John-H-Elliott/ENCE461-PCB-Car-and-Controller/README.md

# ENCE461-PCB-Car-and-Controller

---

## **Overview**

This project was to design two PCBs, one for a remote-controlled car and the other for its controller. These can be found in the hardware section.

These boards were then programmed through a USB-Jtag programmer.

To learn more, refer to the guide used to structure this project in the documents section.

---
