John-H-Elliott/ENCE461-PCB-Car-and-Controller/Hardware/Hat/Final/Final PDFs/WR Hat Group 24.pdf

# USB Voltage Regulator

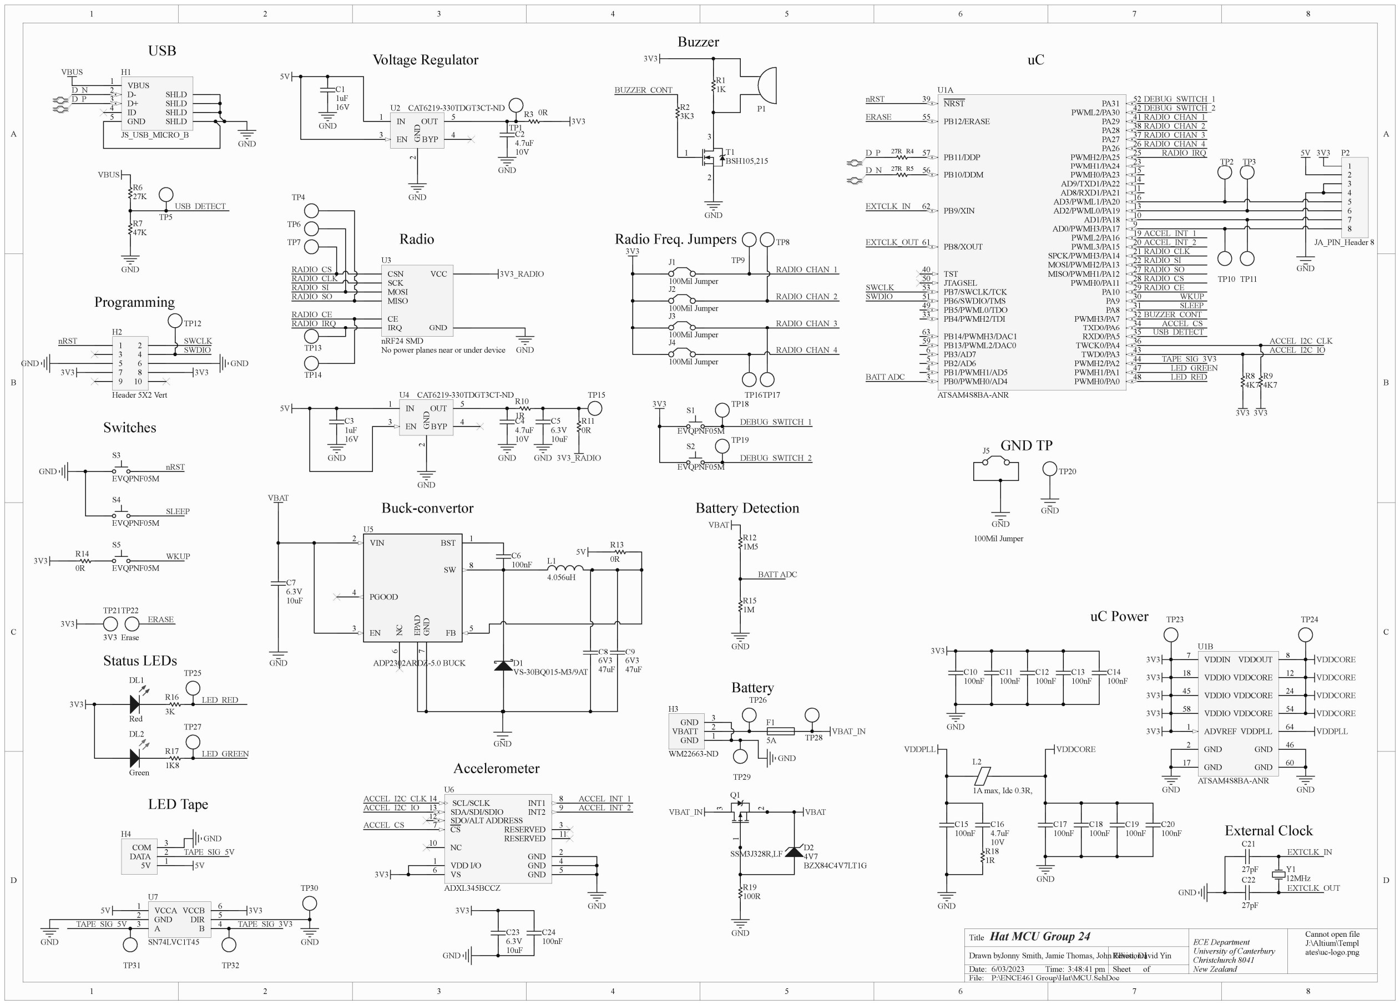
[picture p1: page 1]

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
ECE Department
University of Canterbury
Christchurch 8041
New Zealand

## Hat MCU Group 24

1
6/03/2023 | 3:48:41 pm
P:\ENCE461 Group\Hat\MCU.SchDoc

Title

Drawn by:
Date:
File:

Revision:
Time: | Sheet | of

Jonny Smith, Jamie Thomas, John Elliott, David Yin

Cannot open file
J:\Altium\Templ
ates\uc-logo.png
IN 1 | GND

2

EN 3 | BYP | 4
| OUT | 5

U2 CAT6219-330TDGT3CT-ND

JTAGSEL 50

NRST 39

PWMH0/PA0 | 48 PWMH1/PA1 | 47 PWMH2/PA2 | 44 TWD0/PA3 | 43 TWCK0/PA4 | 36 RXD0/PA5 | 35 TXD0/PA6 | 34 PWMH3/PA7 | 32 PA8 | 31 PA9 | 30 PA10 | 29 PWMH0/PA11 | 28 MISO/PWMH1/PA12 | 27 MOSI/PWMH2/PA13 | 22 SPCK/PWMH3/PA14 | 21 PWML3/PA15 | 20 PWML2/PA16 | 19 AD0/PWMH3/PA17 | 9
AD1/PA18 | 10 AD2/PWML0/PA19 | 13 AD3/PWML1/PA20 | 16 AD8/RXD1/PA21 | 11 AD9/TXD1/PA22 | 14 PWMH0/PA23 | 15 PWMH1/PA24 | 23 PWMH2/PA25 | 25 PA26 | 26 PA27 | 37 PA28 | 38 PA29 | 41 PWML2/PA30 | 42 PA31 | 52

PB0/PWMH0/AD4 3

PB1/PWMH1/AD5 4

PB2/AD6 5

PB3/AD7 6

PB4/PWMH2/TDI 33 | PB5/PWML0/TDO 49 | PB6/SWDIO/TMS 51 | PB7/SWCLK/TCK 53

PB8/XOUT 61

PB9/XIN 62

PB10/DDM 56

PB11/DDP 57

PB12/ERASE 55

PB13/PWML2/DAC0 59 PB14/PWMH3/DAC1 63

TST 40

U1A

ATSAM4S8BA-ANR

GND 2

GND 17

GND | 46
GND | 60
VDDCORE | 12
VDDCORE | 24
VDDCORE | 54

VDDIO 18

VDDIO 45

VDDIO 58

VDDPLL | 64 ADVREF 1
VDDOUT | 8 VDDIN 7

U1B

ATSAM4S8BA-ANR

S3

EVQPNF05M

S4

EVQPNF05M

Green

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
Header 5X2 Vert

# Programming

# Status LEDs

# Switches

# uC Power

uC

5V

1uF
16V

C1

GND

GND

4.7uF
10V

C2

3V3

GND

D_P

D_N

27R R4

VBUS

27K

R6

47K

R7

GND

USB_DETECT

USB_DETECT

GND | GND
3V3 | 3V3 SWCLK
| SWDIO

nRST

SWCLK
SWDIO

nRST

27R R5

12MHz

27pF Y1

C21

27pF

C22
GND

EXTCLK_IN

EXTCLK_OUT

EXTCLK_IN

EXTCLK_OUT

ERASE

ERASE

TP21

3V3

TP22

Erase

3V3

3V3

GND

100nF

C10
100nF

C11
100nF

C12
100nF

C13

3V3

3V3

3V3

3V3

100nF

C14

3V3

GND | GND

100nF

C15
4.7uF
10V

C16

GND

VDDPLL

1R

R18

VDDCORE

GND

100nF

C17
100nF

C18
100nF

C19
100nF

C20

VDDCORE

VDDCORE

VDDCORE

VDDCORE

1A max, Idc 0.3R,

L2

VDDPLL

3V3
3K

R16

1K8

R17

nRST

SLEEP

SLEEP

VCC

GND

CE

CSN
SCK
MOSI
MISO

IRQ

No power planes near or under device

U3

nRF24 SMD
GND

# Radio

IN 1 | GND

2

EN 3 | BYP | 4
| OUT | 5

U4 CAT6219-330TDGT3CT-ND
5V

1uF
16V

C3

GND

GND

4.7uF
10V

C4

GND | 3V3_RADIO

3V3_RADIO

6.3V
10uF

C5

GND

1R

R10

RADIO_CS
RADIO_CLK
RADIO_SI
RADIO_SO

RADIO_CE
RADIO_IRQ

RADIO_CS

RADIO_CLK
RADIO_SI
RADIO_SO

RADIO_CE

RADIO_IRQ

LED_GREEN

LED_RED

LED_RED

LED_GREEN

5V | 1
DATA | 2
COM | 3

H4

5V

GND

# LED Tape

VCCA 1
GND 2
A

### 3 B

4

DIR | 5
VCCB | 6

U7

GND | SN74LVC1T45
5V | 3V3

GND

TAPE_SIG_5V

TAPE_SIG_5V

TAPE_SIG_3V3

TAPE_SIG_3V3

VDD I/O 1

GND | 2
RESERVED | 3
GND | 4
GND | 5 VS 6

CS 7

| INT1 | 8
| INT2 | 9
NC 10 | RESERVED | 11
SDO/ALT ADDRESS 12 | SDA/SDI/SDIO 13 | SCL/SCLK 14

U6

ADXL345BCCZ

GND

3V3

3V3

GND

6.3V
10uF

C23
100nF

C24

ACCEL_I2C_CLK
ACCEL_I2C_IO

ACCEL_CS

ACCEL_CS

ACCEL_INT_1
ACCEL_INT_2

ACCEL_INT_1
ACCEL_INT_2

# Accelerometer

P1

3V3

1K

R1

BSH105,215

3
1

2

T1

3K3

R2

BUZZER_CONT

GND

BUZZER_CONT

# Buzzer

J1

100Mil Jumper
J2

100Mil Jumper
J3

100Mil Jumper
J4

100Mil Jumper

3V3

RADIO_CHAN_1

RADIO_CHAN_2

RADIO_CHAN_3

RADIO_CHAN_4

RADIO_CHAN_1
RADIO_CHAN_2
RADIO_CHAN_3
RADIO_CHAN_4

# Radio Freq. Jumpers

S1

EVQPNF05M
S2

EVQPNF05M

3V3

DEBUG_SWITCH_1

DEBUG_SWITCH_2

DEBUG_SWITCH_1
DEBUG_SWITCH_2

TP30

TP7

TP6

TP4

TP13

TP14

0R

R11

TP15

TP23 | TP24

TP25

TP27

TP5

R3 0R
TP1

VBUS 1
D- 2
D+ 3
ID 4
GND 5 | SHLD

SHLD

SHLD

SHLD

H1

JS_USB_MICRO_B

VBUS

D_N
D_P

GND

TP19

TP18

GND

TP31 | TP32

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
JA_PIN_Header 8

GND
TP10 TP11

TP2 TP3

5V 3V3

TP16TP17

TP9

TP8

FB | 5
VIN 2 | BST | 1 NC | EPAD

6

PGOOD 4

EN 3

SW 8 GND

7

U5

ADP2302ARDZ-5.0 BUCK

VBAT

5V

6.3V
10uF

C7

GND

100nF

C6

6V3
47uF

C8
6V3
47uF

C9

GND

D1
VS-30BQ015-M3/9AT

4.056uH

L1

# Buck-convertor

J5

100Mil Jumper

GND

GND

TP20

# GND TP

# External Clock

TP12

1M5

R12

1M

R15

GND

VBAT

BATT ADC

BATT ADC

# Battery Detection

GND | 1
VBATT | 2
GND | 3

WM22663-ND

H3

VBAT_IN

GND

# Battery

5A

F1
TP28

TP29

TP26

SSM3J328R,LF ³

1

2

Q1

VBAT_IN

GND

BZX84C4V7LT1G

D2
4V7

100R

R19

VBAT

0R

R13

3V3

WKUP

S5

EVQPNF05M

WKUP

3V3
0R

R14

4K7

R9

3V3

ACCEL_I2C_CLK
ACCEL_I2C_IO

4K7

R8
