John-H-Elliott/ENCE461-PCB-Car-and-Controller/Documents/guide/figs/chassis.jpg

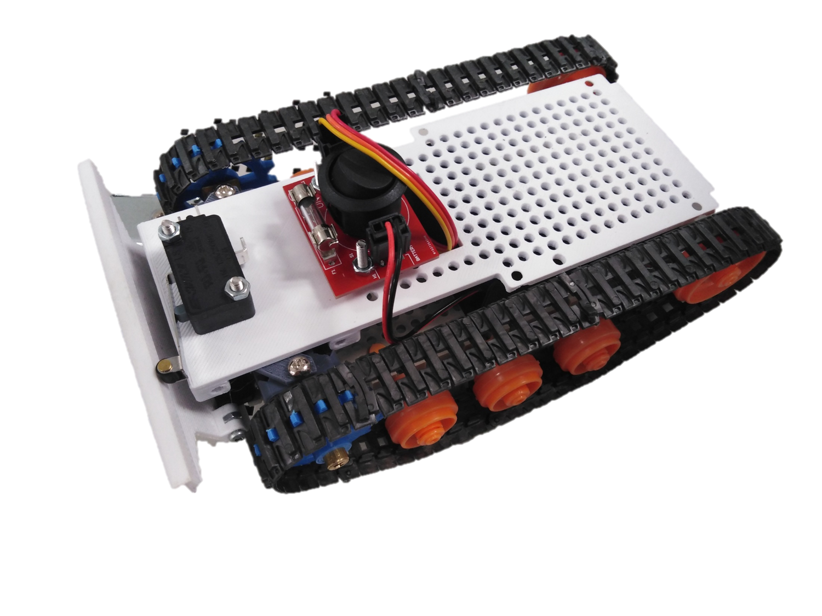
Documents/guide/figs/chassis.jpg
