John-H-Elliott/ENCE461-PCB-Car-and-Controller/Documents/guide/figs/ClockSignal.png

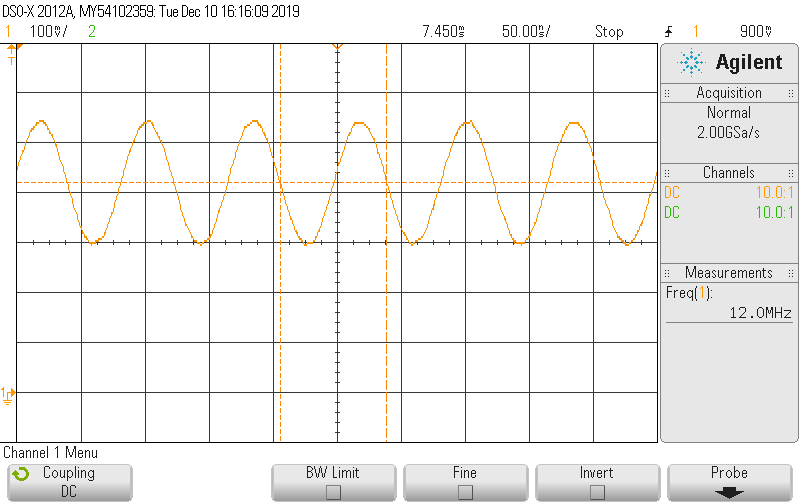
Documents/guide/figs/ClockSignal.png
