John-H-Elliott/ENCE461-PCB-Car-and-Controller/Documents/guide/figs/i2c-ack.png

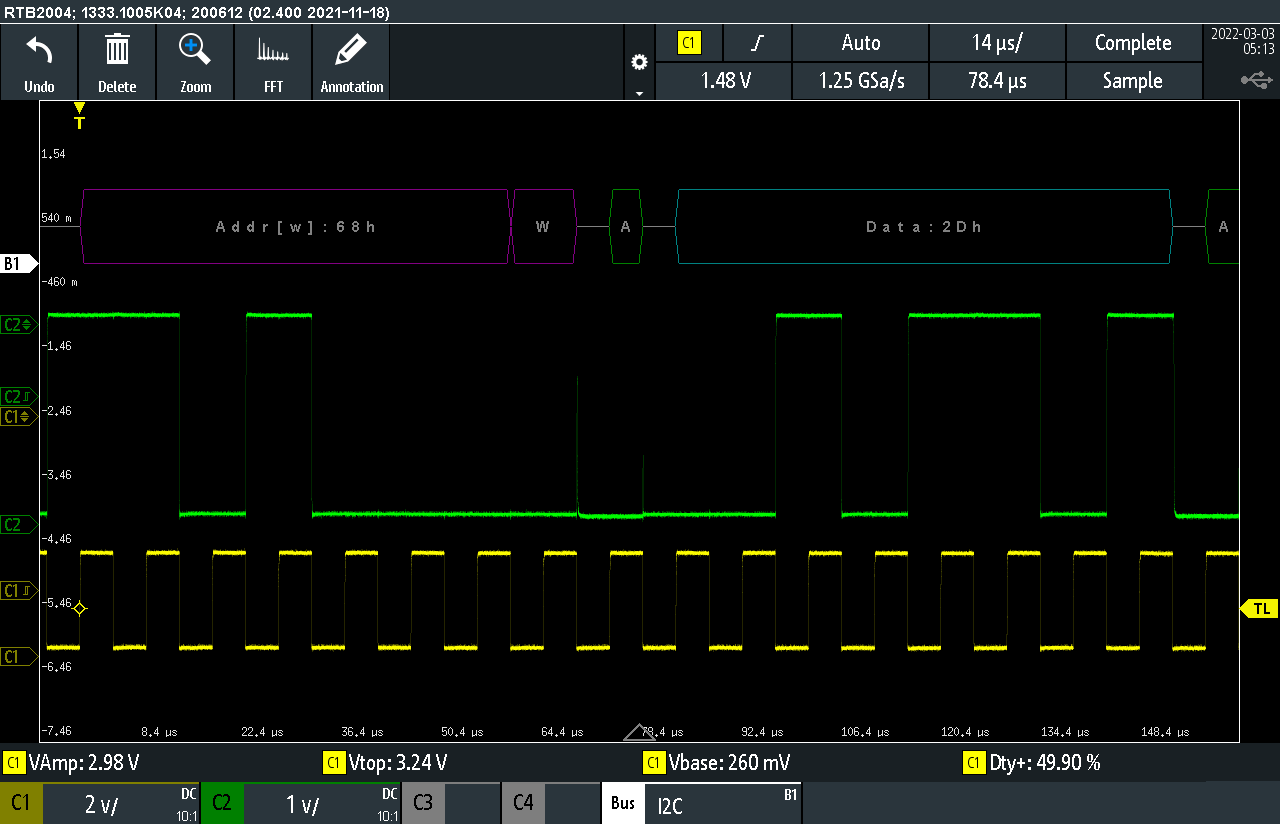
Documents/guide/figs/i2c-ack.png
