John-H-Elliott/ENCE461-PCB-Car-and-Controller/Documents/guide/figs/jumpers4.jpg

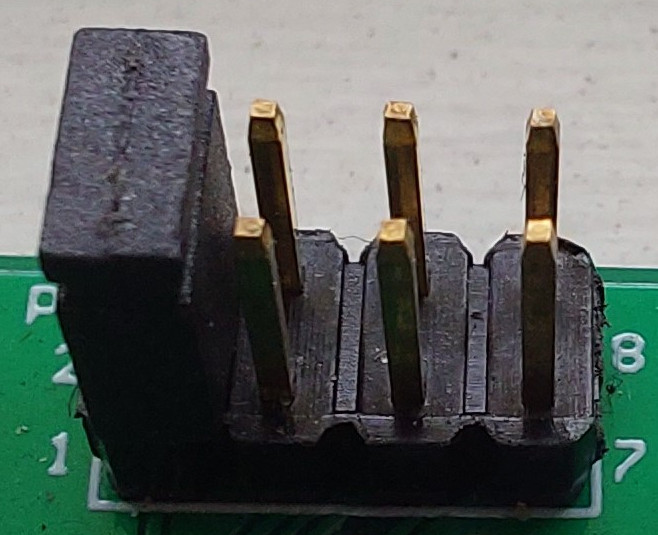
Documents/guide/figs/jumpers4.jpg
