John-H-Elliott/ENCE461-PCB-Car-and-Controller/Documents/guide/figs/jumpers.jpg

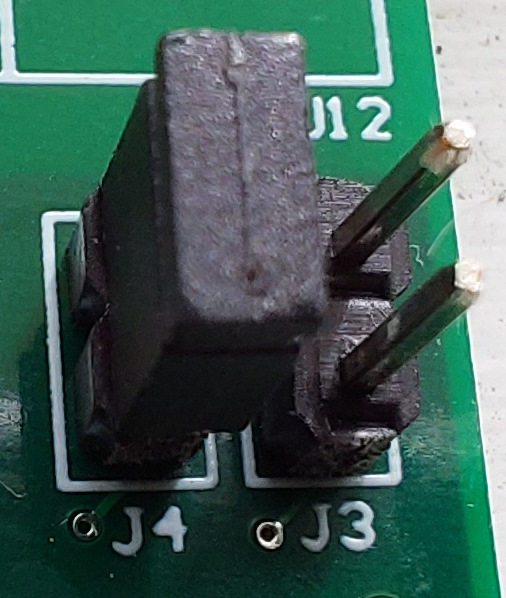
Documents/guide/figs/jumpers.jpg
