John-H-Elliott/ENCE461-PCB-Car-and-Controller/Documents/guide/figs/led_tape.jpg

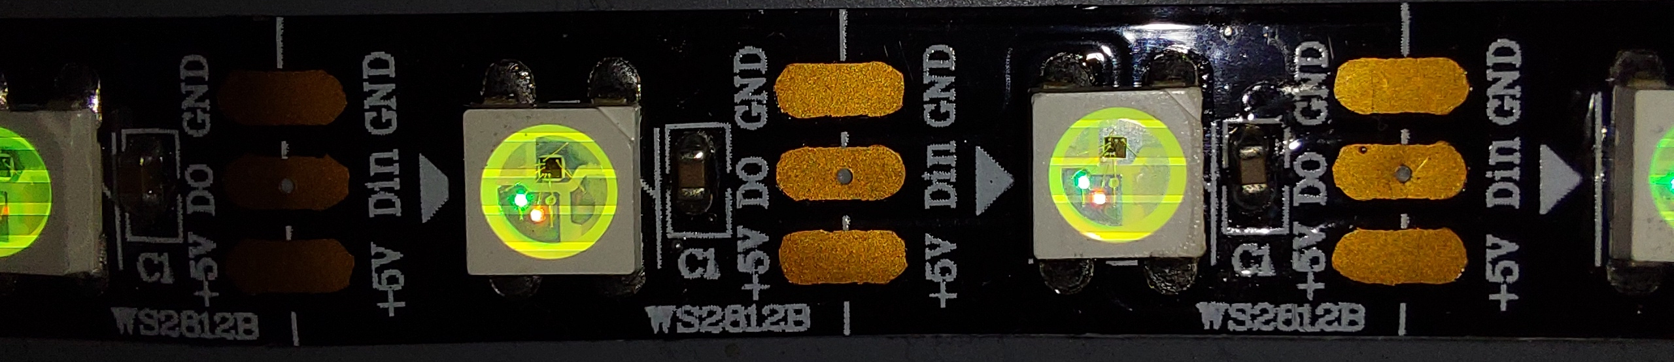
Documents/guide/figs/led_tape.jpg
