John-H-Elliott/ENCE461-PCB-Car-and-Controller/Documents/guide/figs/nrf24.jpg

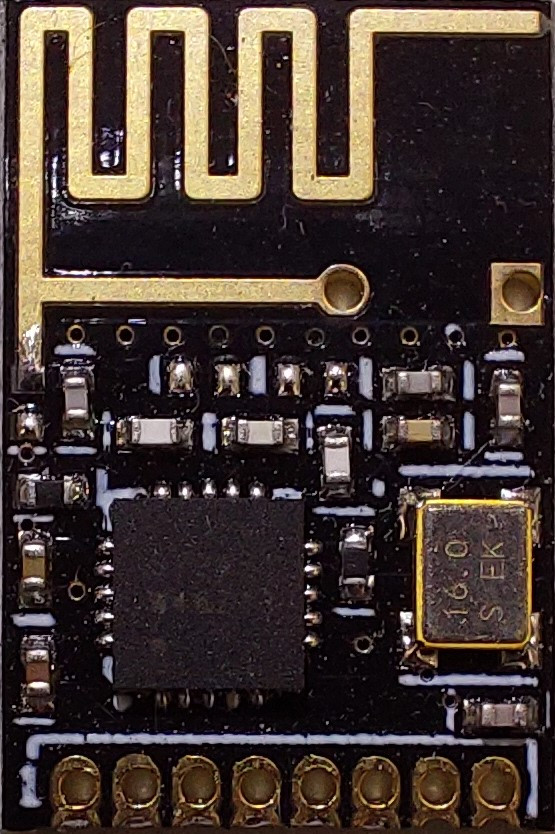
Documents/guide/figs/nrf24.jpg
