John-H-Elliott/ENCE461-PCB-Car-and-Controller/Documents/guide/figs/OpenOCDPollingGood.png

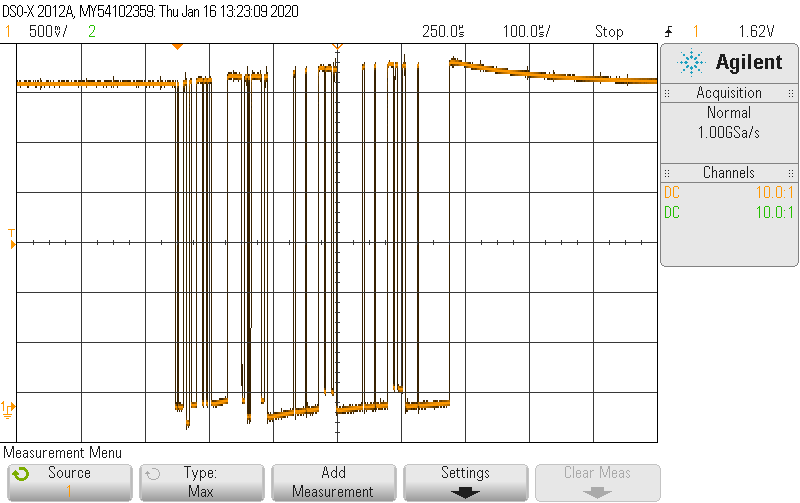
Documents/guide/figs/OpenOCDPollingGood.png
