John-H-Elliott/ENCE461-PCB-Car-and-Controller/Documents/guide/figs/OpenOCDTimingGood.png

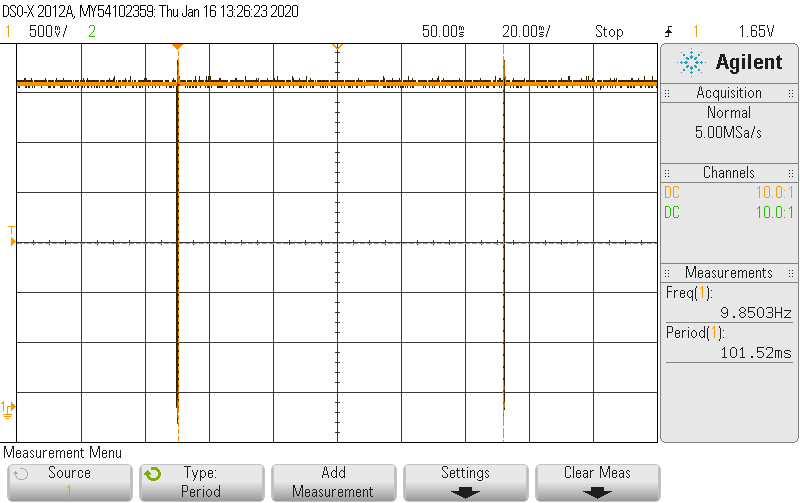
Documents/guide/figs/OpenOCDTimingGood.png
