John-H-Elliott/ENCE461-PCB-Car-and-Controller/Documents/guide/figs/probe-compensated.jpg

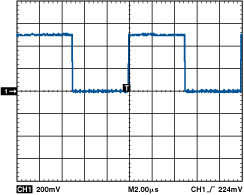
Documents/guide/figs/probe-compensated.jpg
