John-H-Elliott/ENCE461-PCB-Car-and-Controller/Documents/guide/figs/probe-overcompensated.jpg

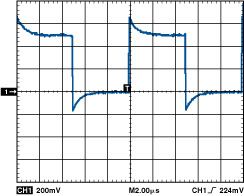
Documents/guide/figs/probe-overcompensated.jpg
