John-H-Elliott/ENCE461-PCB-Car-and-Controller/Documents/guide/figs/PWM_2.png

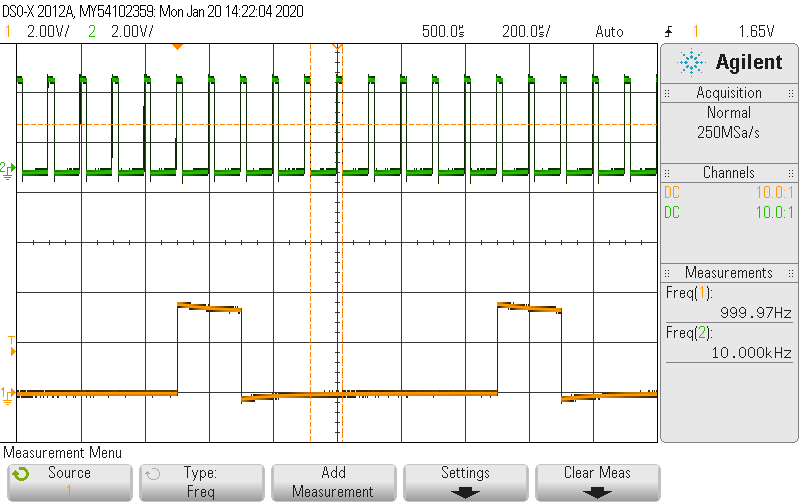
Documents/guide/figs/PWM_2.png
