John-H-Elliott/ENCE461-PCB-Car-and-Controller/Documents/guide/figs/solder_bridge.jpg

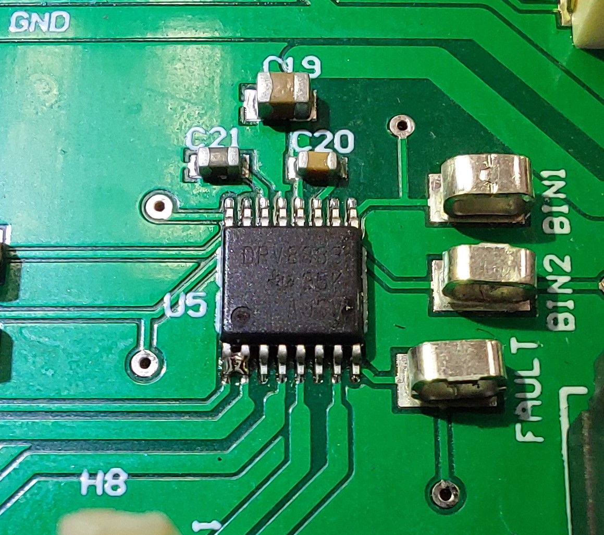
Documents/guide/figs/solder_bridge.jpg
