John-H-Elliott/ENCE461-PCB-Car-and-Controller/Documents/guide/figs/wacky_mural.jpg

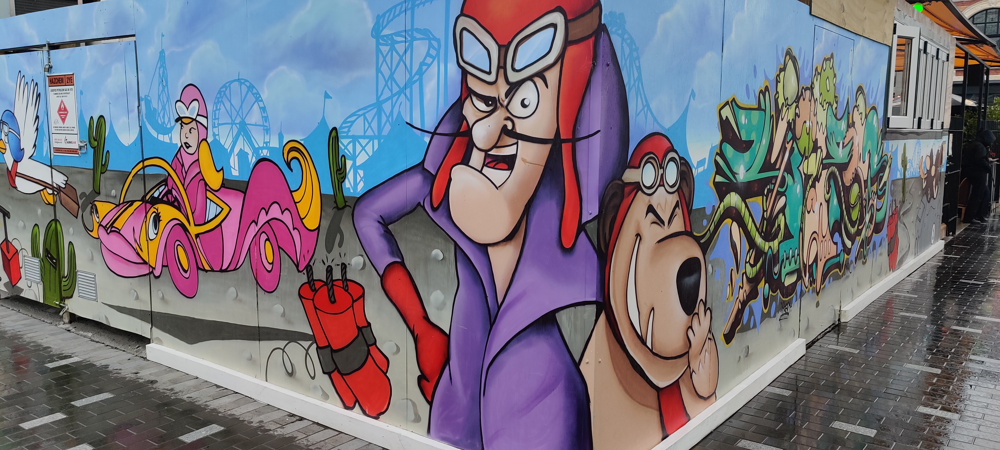
Documents/guide/figs/wacky_mural.jpg
