John-H-Elliott/ENCE461-PCB-Car-and-Controller/Hardware/Car/Final/Final PDFs/Wacky_Racers_extras.pdf

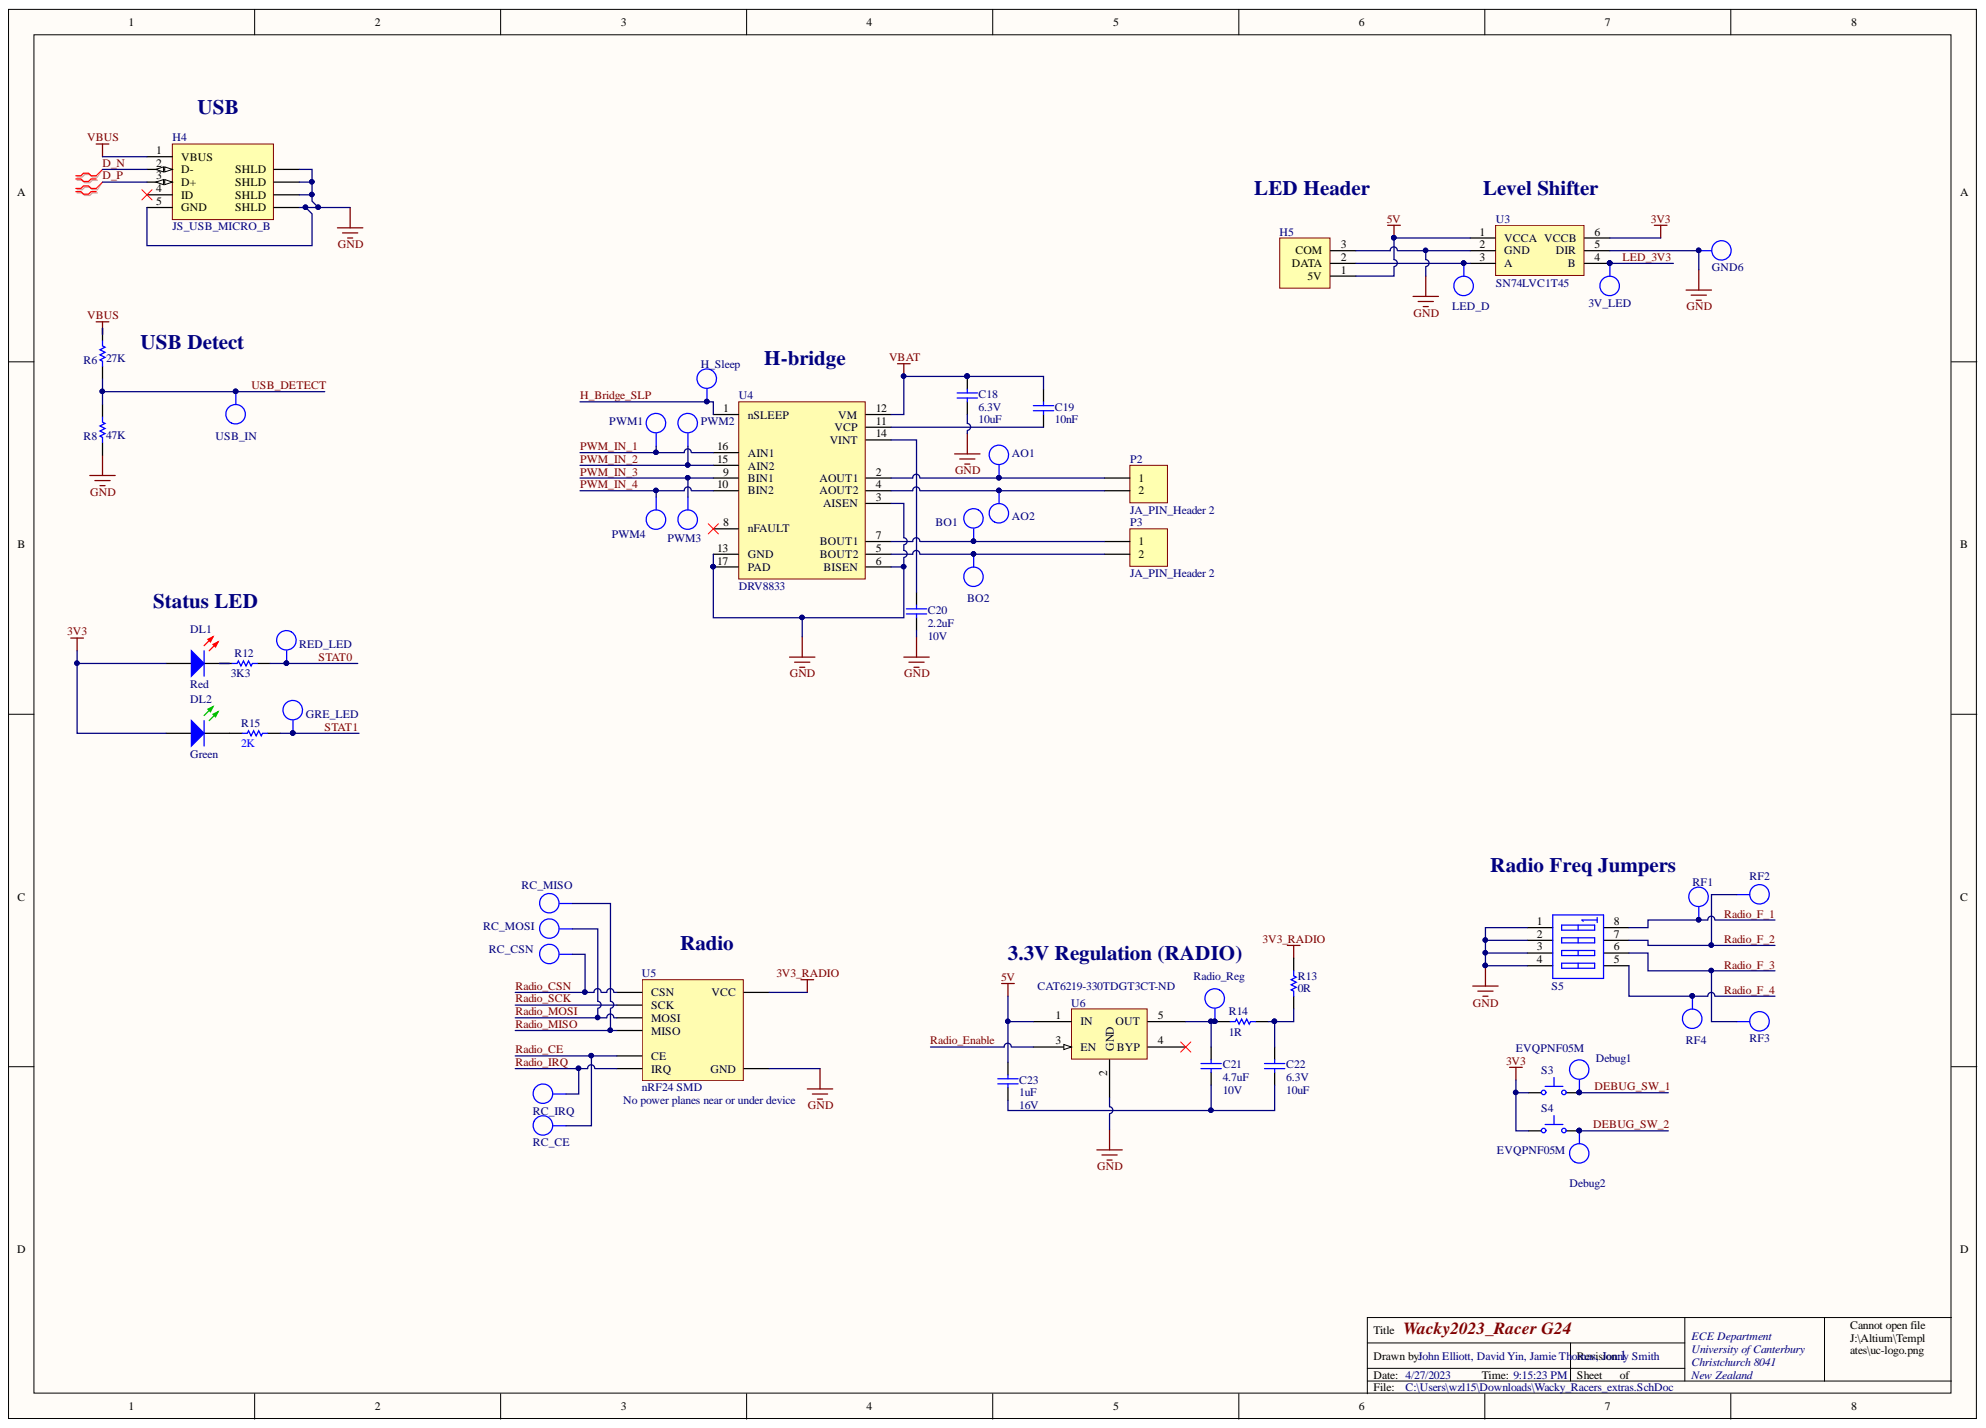
[picture p25: page 1]

IRQ
nRF24 SMD
No power planes near or under device

Wacky2023_Racer G24 Title | ECE Department University of Canterbury Christchurch 8041 New Zealand | Cannot open file J:\Altium\Templ ates\uc-logo.png

Drawn by: John Elliott, David Yin, Jamie Thomas, Jonny Smith | Revision: 1

Date: 4/27/2023 Time: 9:15:23 PM | Sheet of

# Board Stack Report
