John-H-Elliott/ENCE461-PCB-Car-and-Controller/Hardware/Hat/Final/Final PDFs/Wacky_Racers_Group24_Hat.pdf

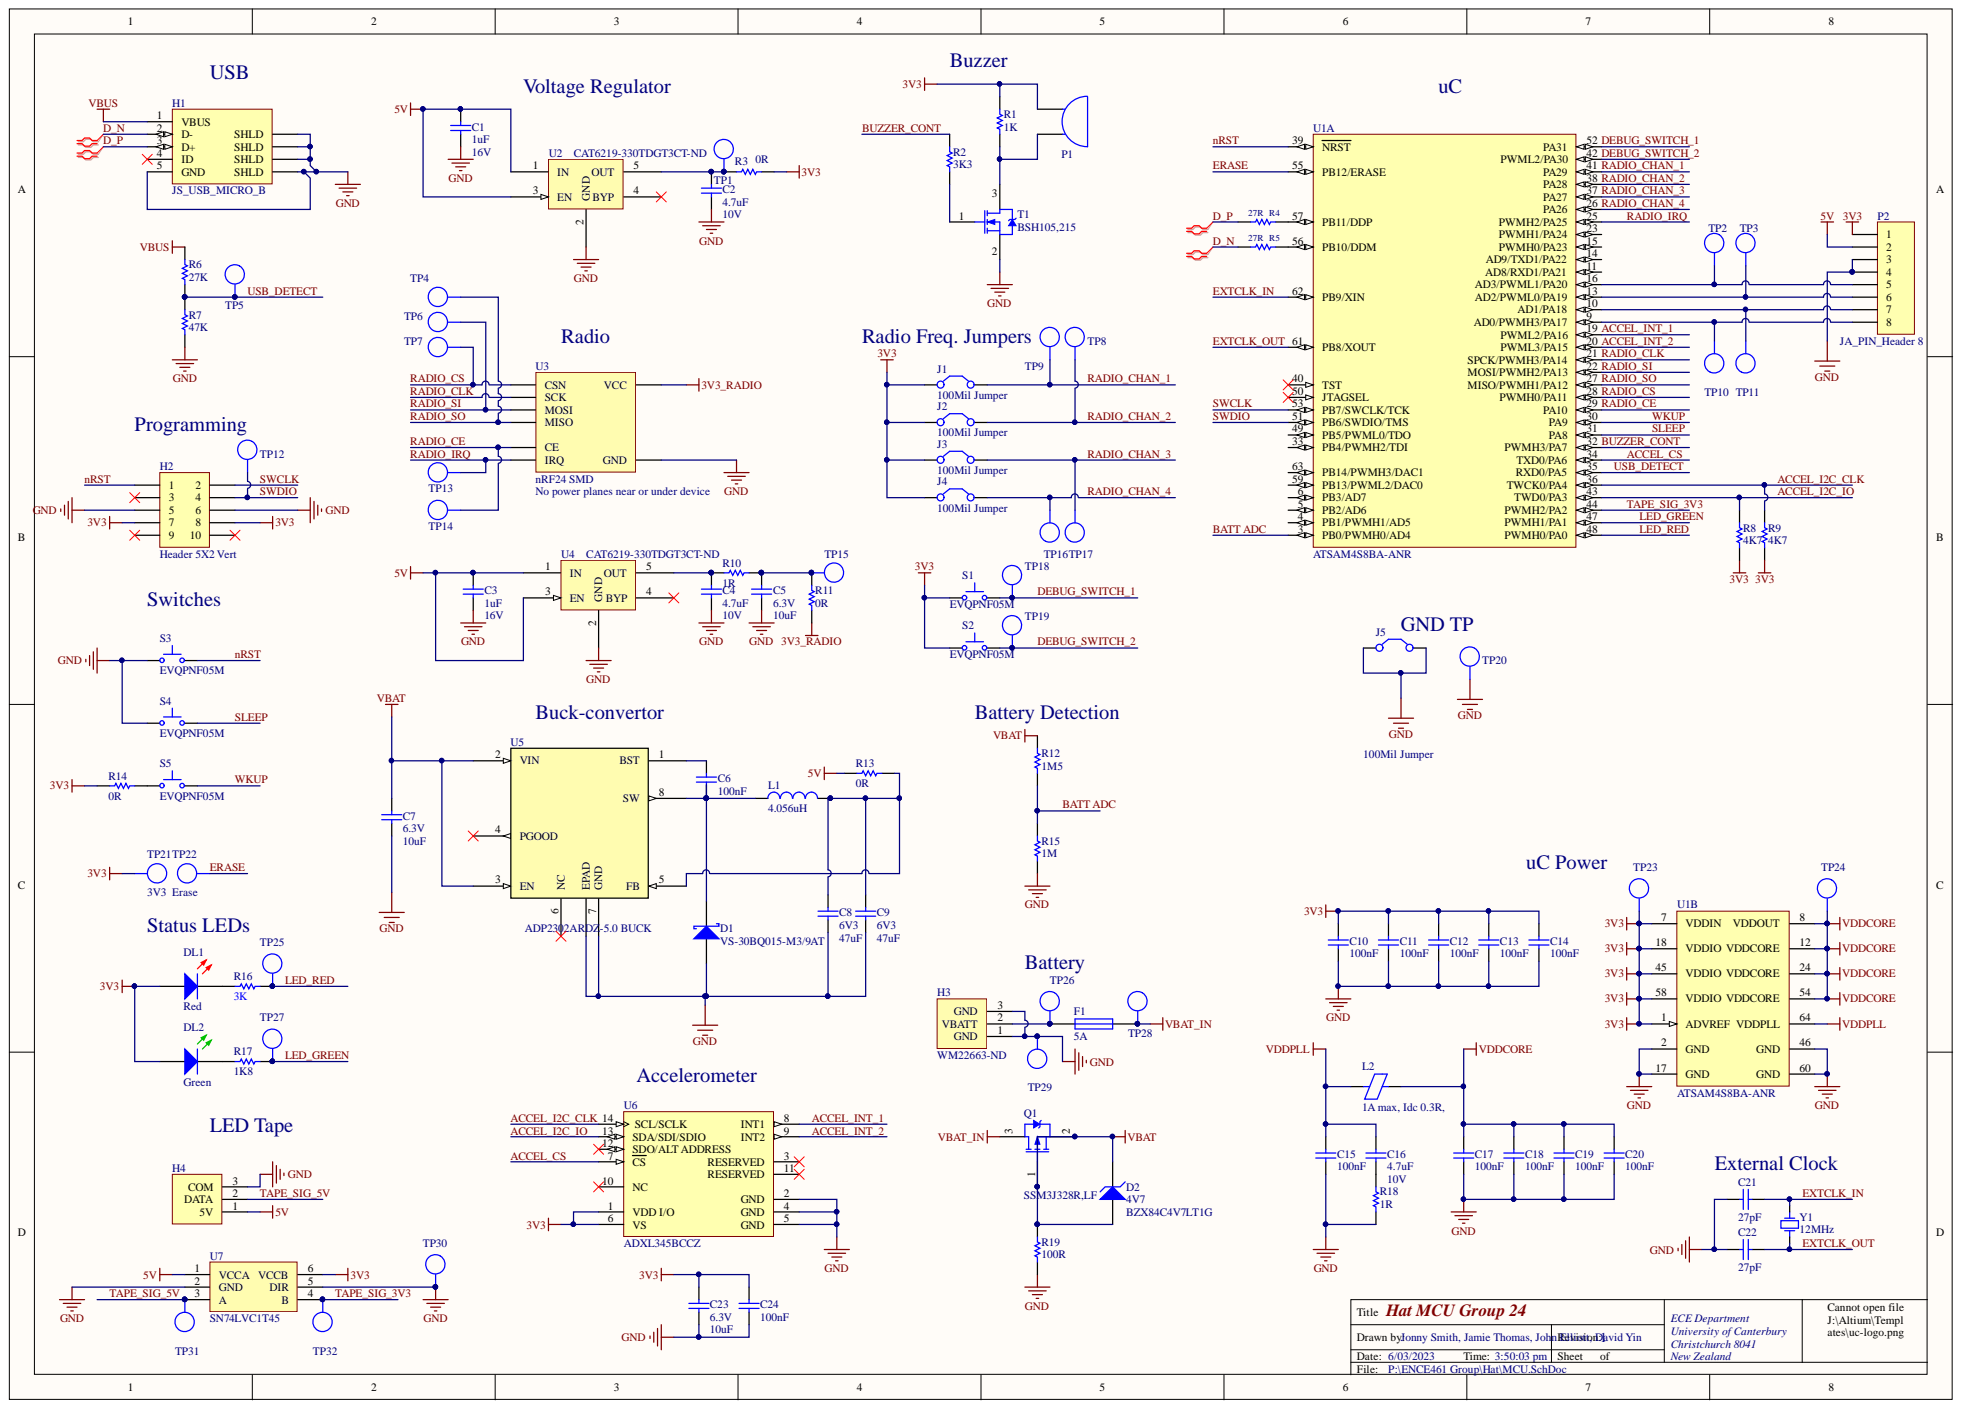
[picture p26: page 1]

IRQ
nRF24 SMD
No power planes near or under device

VDDIO 58

GND 2

Cannot open file
J:\Altium\Templ
ates\uc-logo.png

Drawn by:
P:\ENCE461 Group\Hat\MCU.SchDoc

Jonny Smith, Jamie Thomas, John Elliott, David Yin
