John-H-Elliott/ENCE461-PCB-Car-and-Controller/Hardware/Hat/Final/Final PDFs/Wacky_Racers_Group24_Hat_V2.pdf

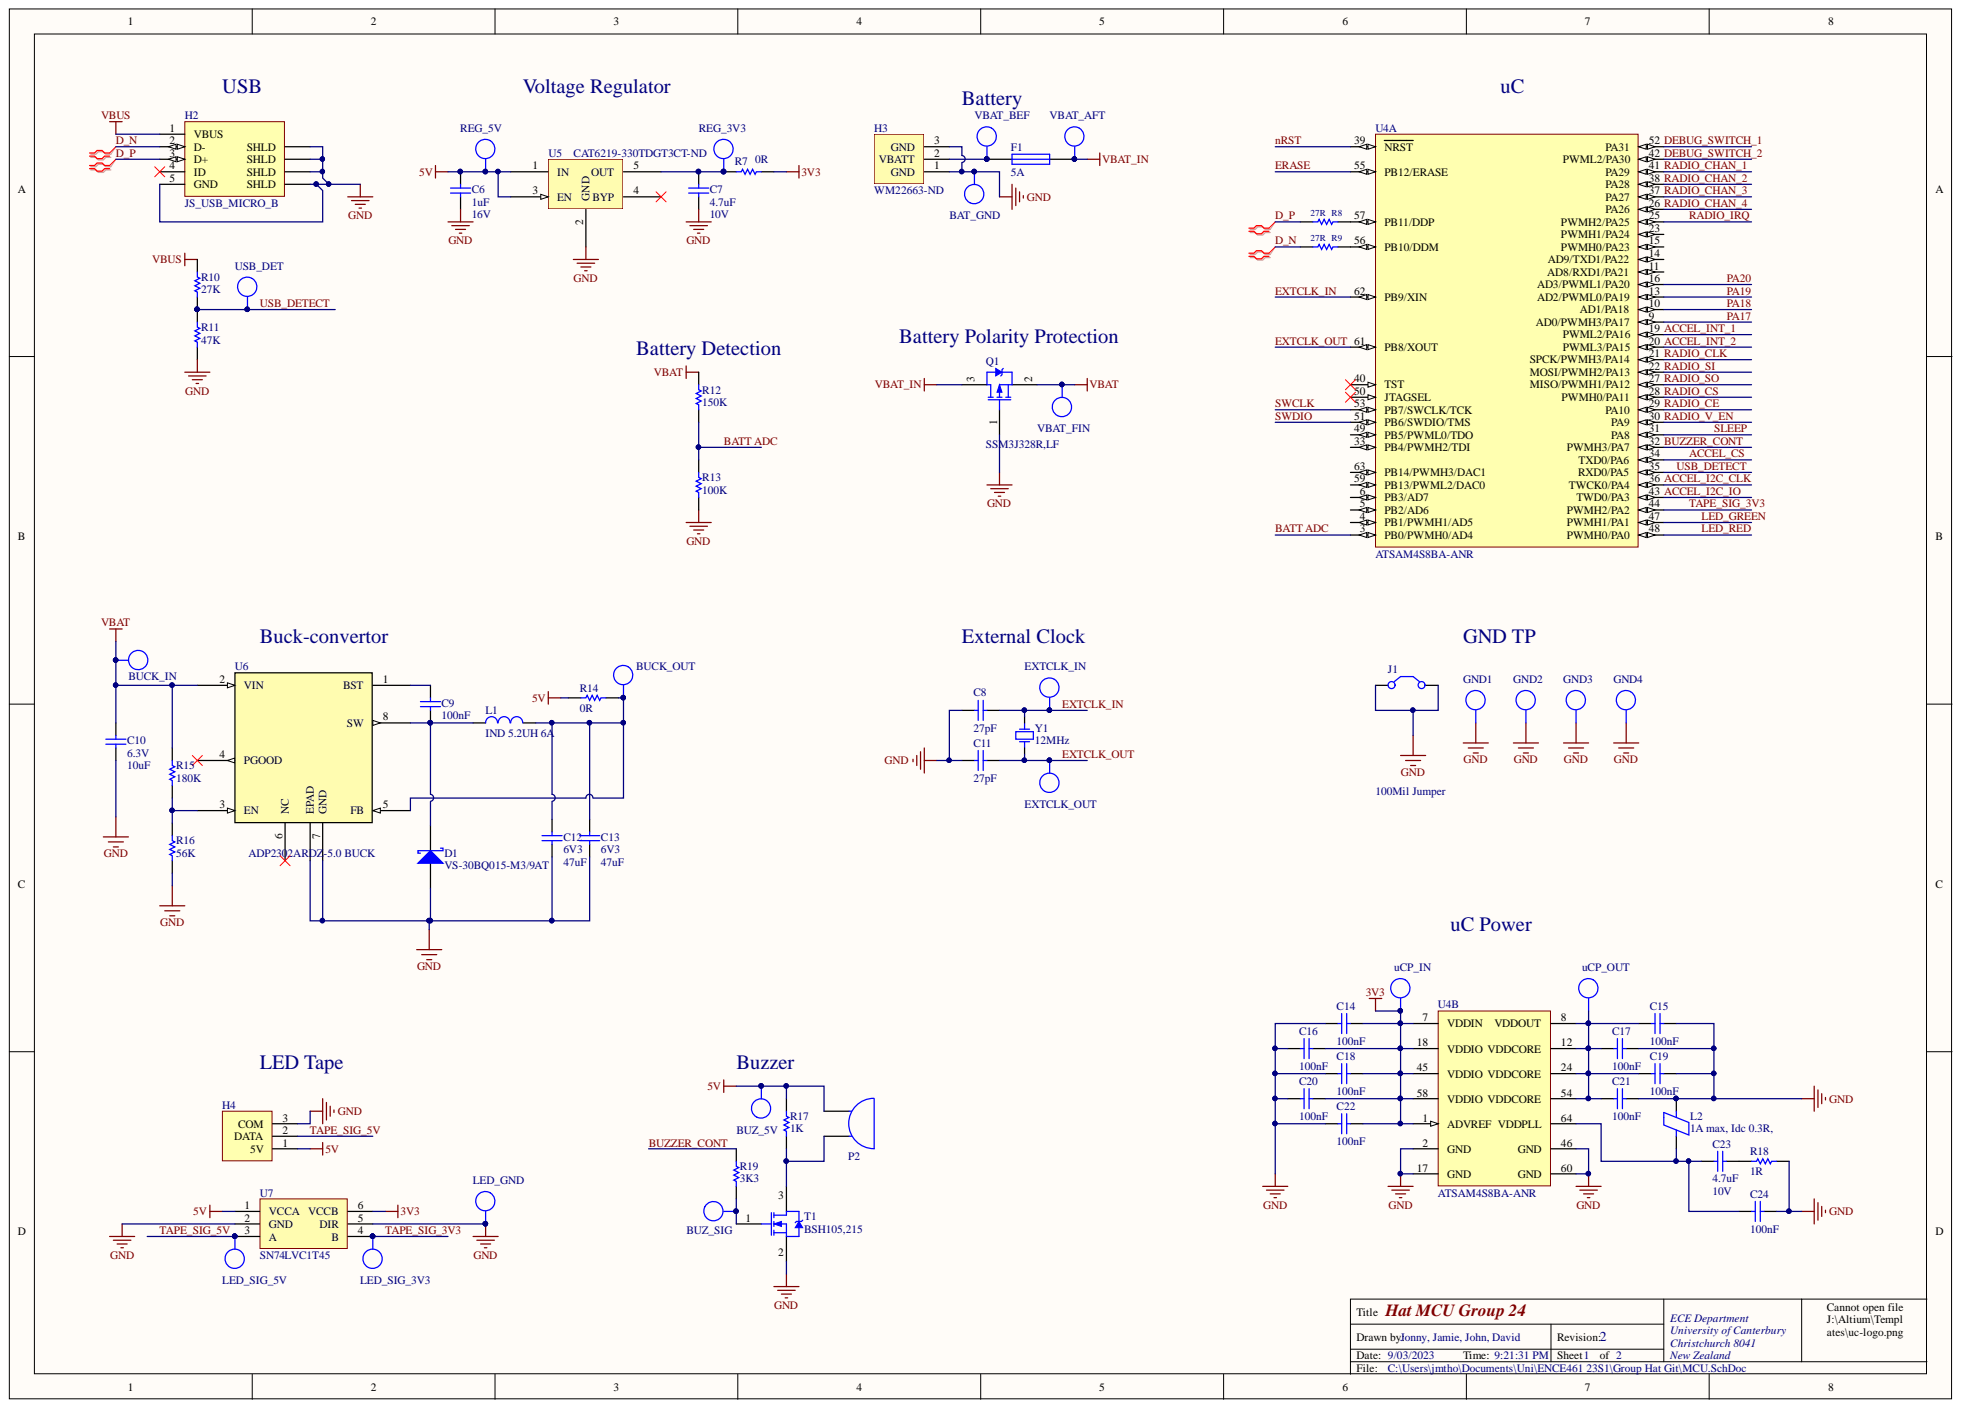
[picture p27: page 1]

Hat MCU Group 24 Title | ECE Department University of Canterbury Christchurch 8041 New Zealand | Cannot open file J:\Altium\Templ ates\uc-logo.png

Drawn by: Jonny, Jamie, John, David | Revision: 2
Date: 9/03/2023 Time: 9:21:31 PM | Sheet 1 of 2

C:\Users\jmtho\Documents\Uni\ENCE461 23S1\Group Hat Git\MCU.SchDoc

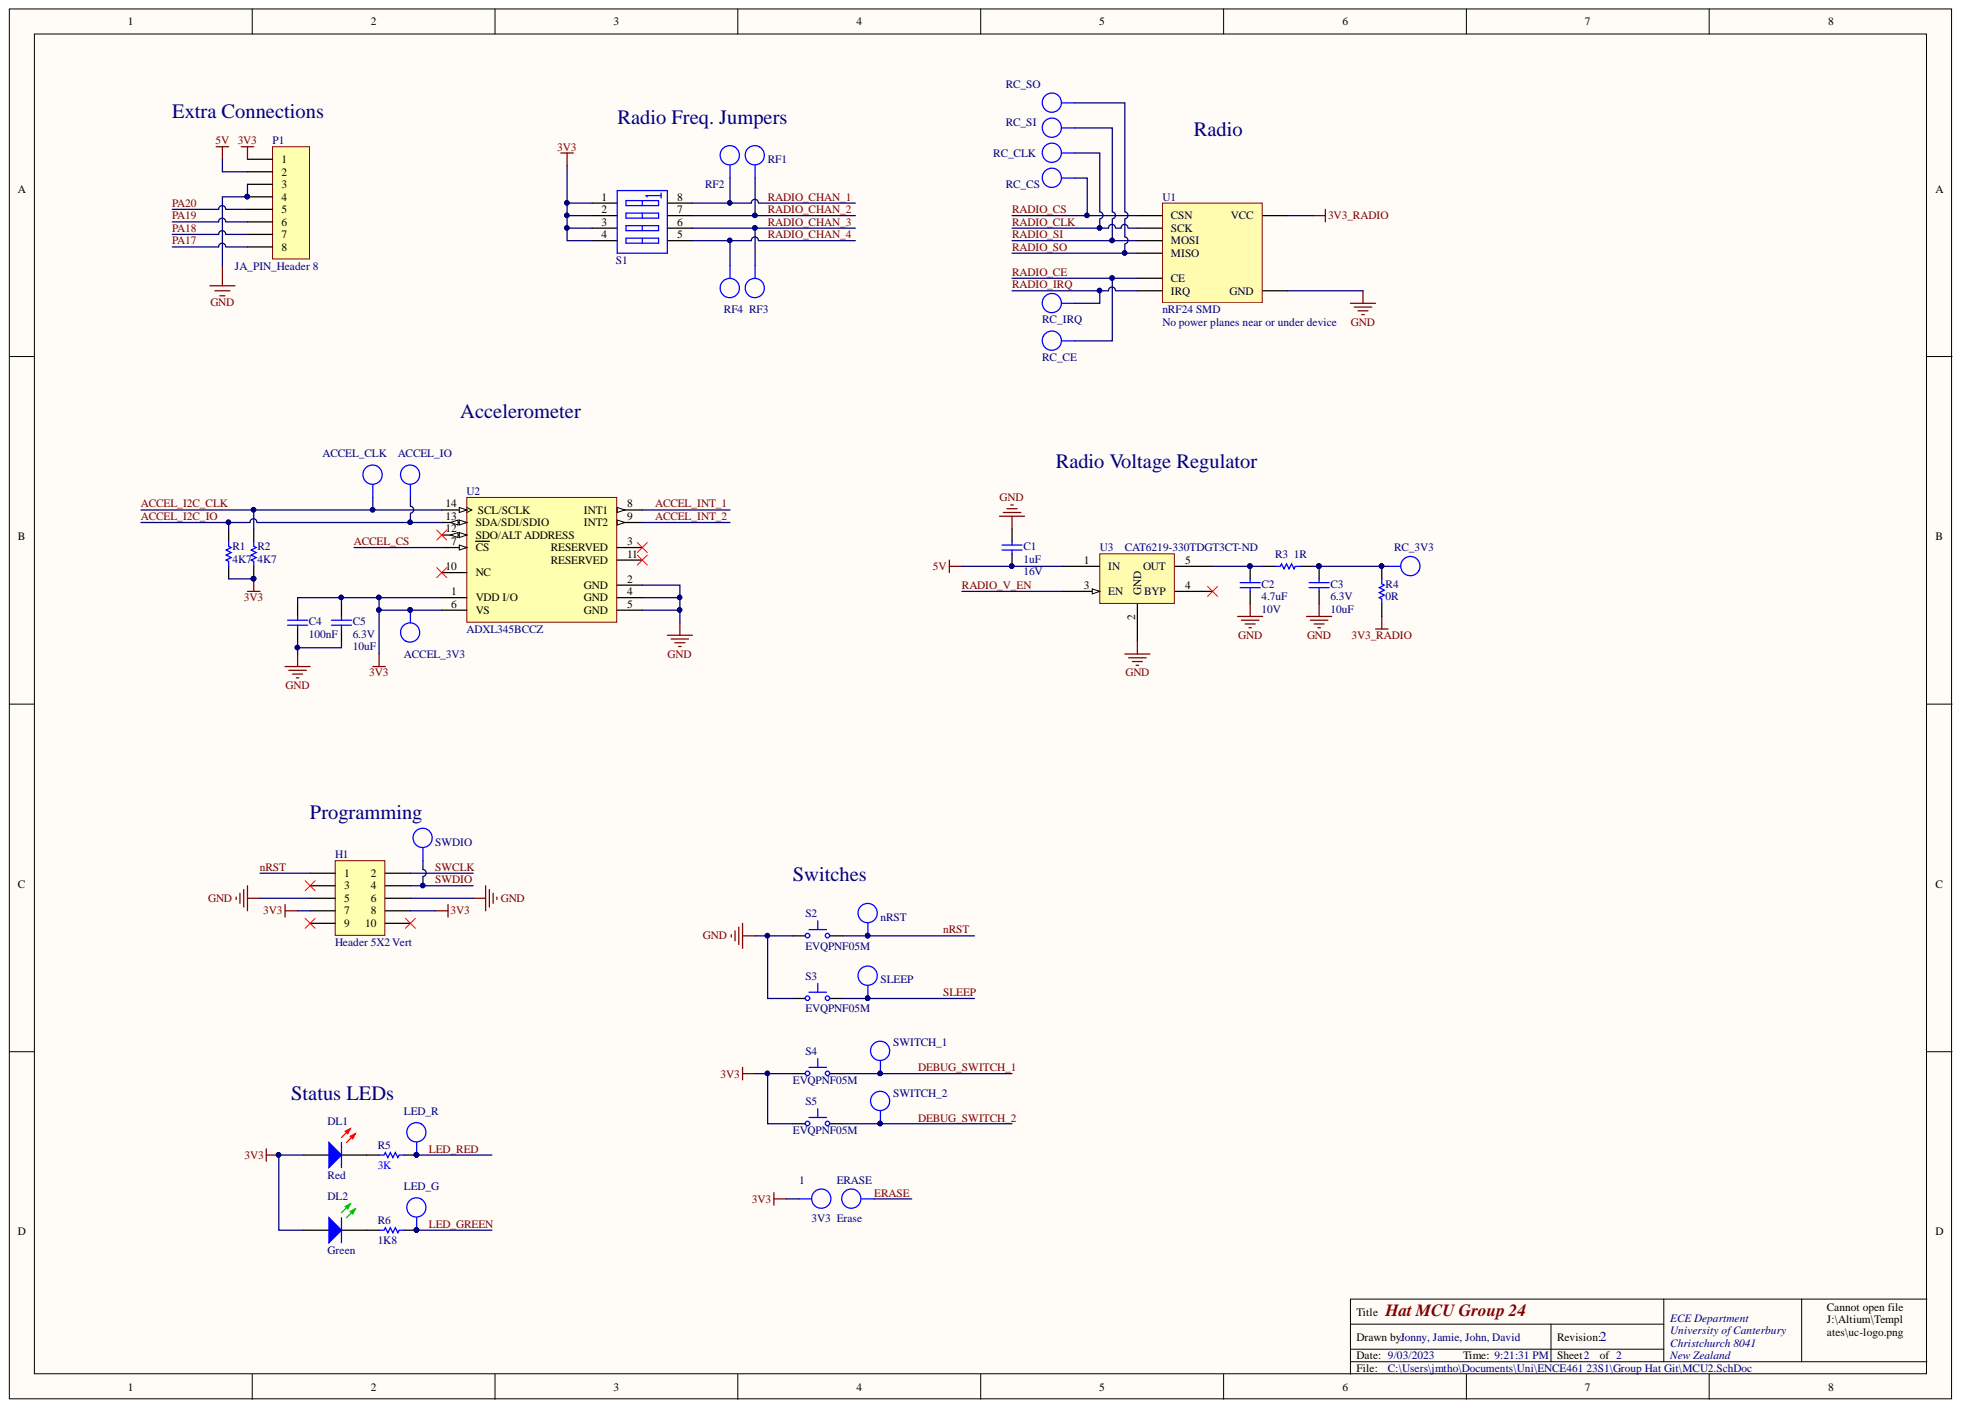
[picture p28: page 2]

IRQ
nRF24 SMD
No power planes near or under device

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

Drawn by: Jonny, Jamie, John, David | Revision: 2
Date: 9/03/2023 Time: 9:21:31 PM | Sheet 2 of 2

C:\Users\jmtho\Documents\Uni\ENCE461 23S1\Group Hat Git\MCU2.SchDoc
