John-H-Elliott/ENCE461-PCB-Car-and-Controller/Hardware/Car/Final/Final PDFs/Schematic PDF.pdf

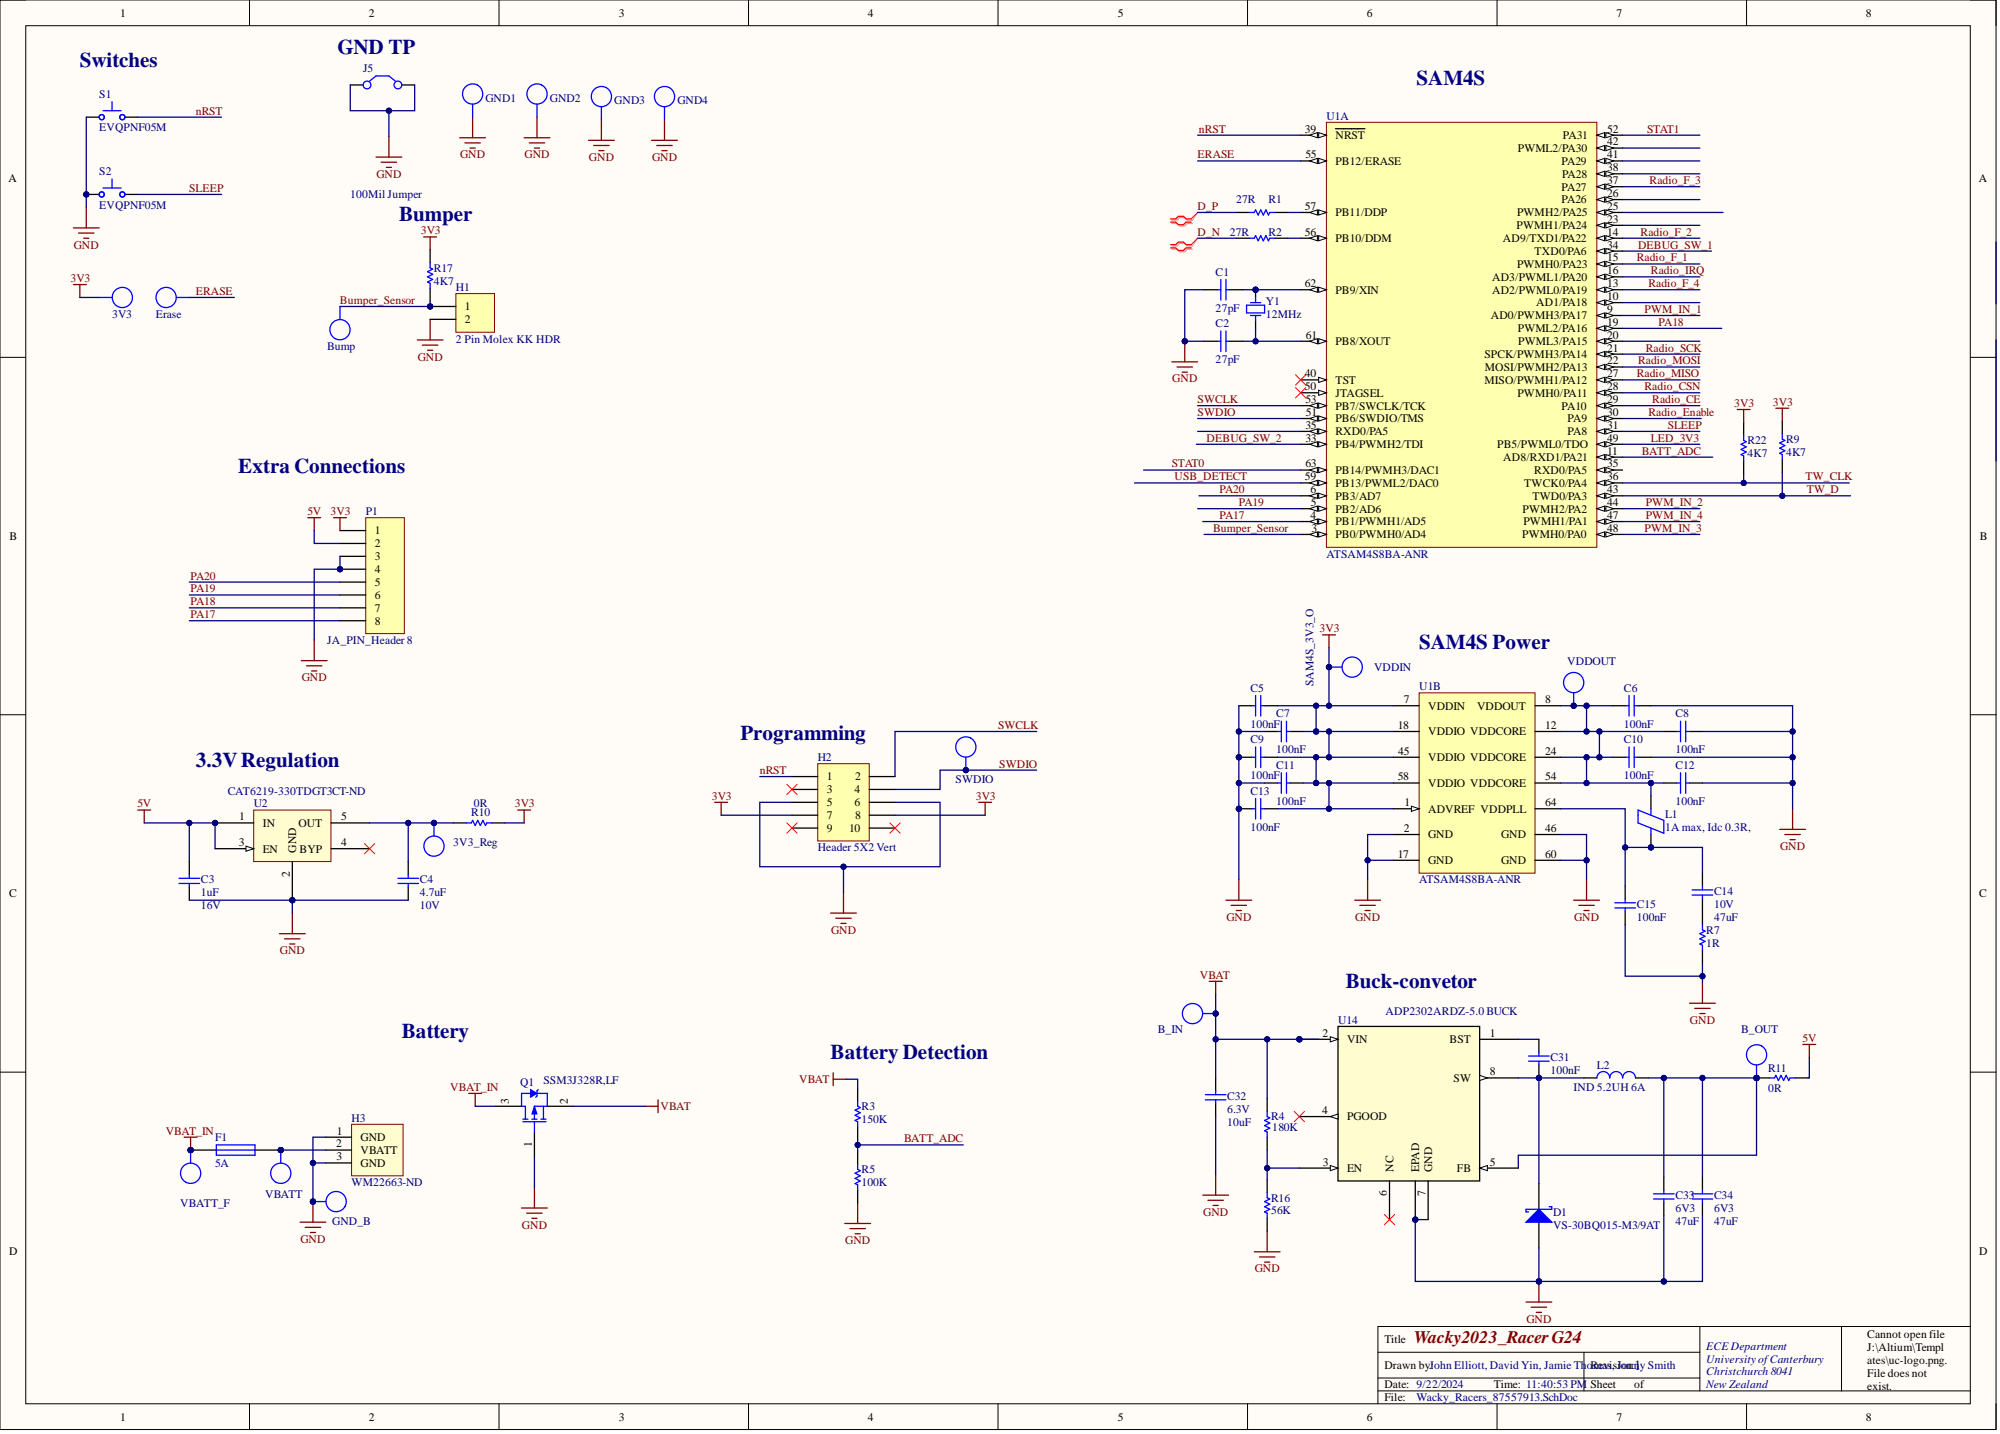
[picture p29: page 1]

PGOOD 4

VBATT 2

Cannot open file
J:\Altium\Templ
ates\uc-logo.png.
File does not
exist.

John Elliott, David Yin, Jamie Thomas, Jonny Smith
