John-H-Elliott/ENCE461-PCB-Car-and-Controller/(list of files, drawings)

Other design files:
Hardware/Car/Designs/Wacky_Racers_87557913.PrjPcb
Hardware/Car/Designs/Wacky_Racers_87557913.SchDoc
Hardware/Car/Designs/Wacky_Racers_extras.SchDoc
Hardware/Car/Final/Final PCBs/Alternative_Design.PcbDoc
Hardware/Car/Final/Final PCBs/Group24_87557913_98040483_PCB_Wacky_R_CAR.PcbDoc
Hardware/Hat/Designs/hat_template 2023.PcbDoc
Hardware/Hat/Designs/tut_1.PrjPcb
Hardware/Hat/Final/Final PCBs/MCU2.SchDoc
Hardware/Hat/Final/Final PCBs/MCU.SchDoc
