John-H-Elliott/ENCE461-PCB-Car-and-Controller/(commit log)

2024-09-22 Upload
    Uploading all work from ENCE project.
    [Alternative_Design.PcbDoc, Group24_87557913_98040483_PCB_Wacky_R_CAR.PcbDoc, MCU.SchDoc, MCU2.SchDoc, Wacky_Racers_87557913.PrjPcb, Wacky_Racers_87557913.SchDoc, Wacky_Racers_extras.SchDoc, arm7_ft2232.cfg]
2024-09-22 Update
    Update
    [openocd.sch]
